antmicro/myra-sip-interposer/assets/previews/layer0.png

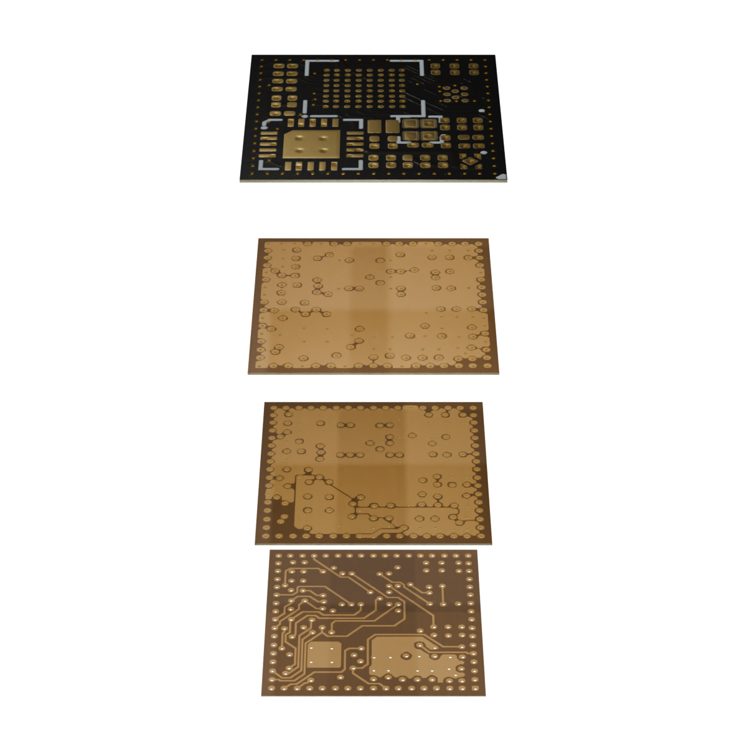
assets/previews/layer0.png
