antmicro/myra-sip-interposer/assets/previews/layer2_thumbnail.png

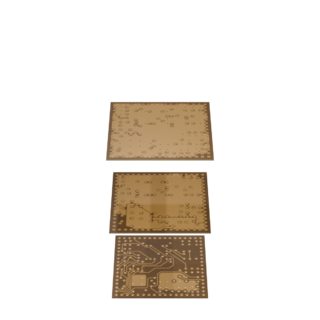
assets/previews/layer2_thumbnail.png
