antmicro/myra-sip-interposer/assets/previews/layer3.png

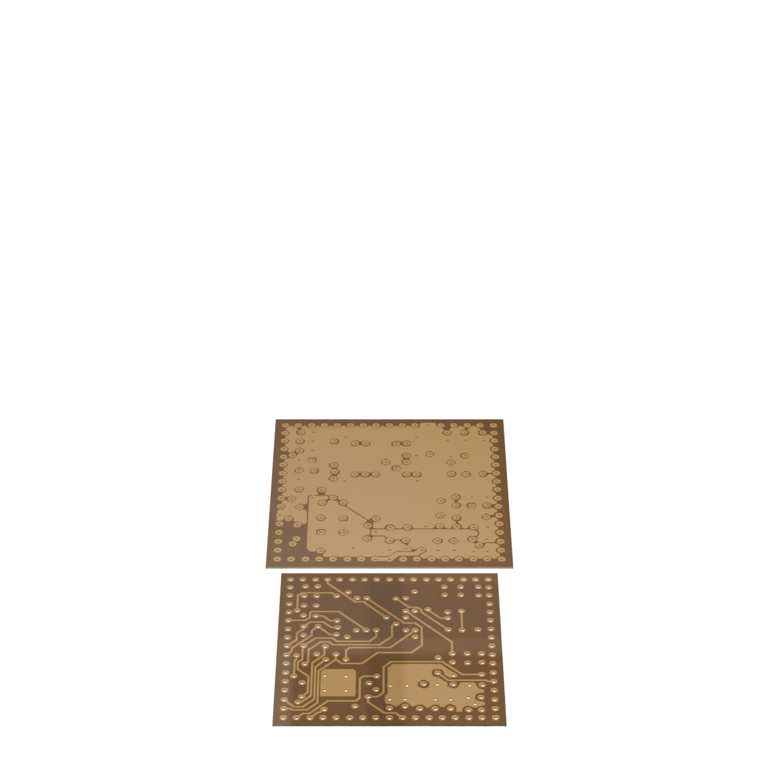
assets/previews/layer3.png
