antmicro/myra-sip-interposer/assets/previews/leftB.png

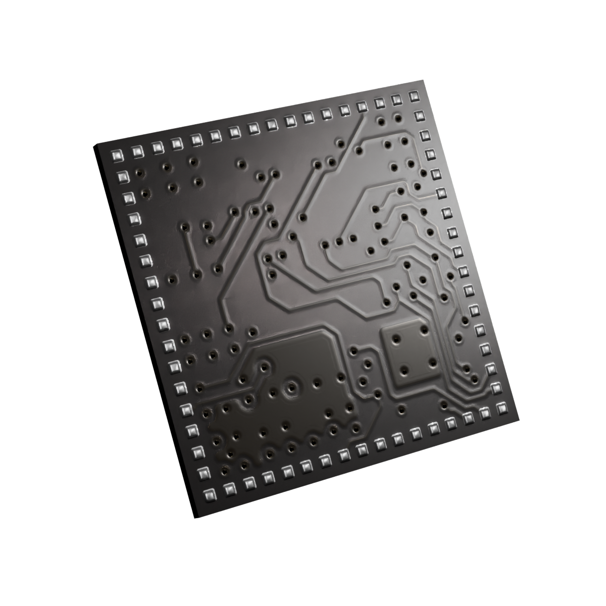
assets/previews/leftB.png
