antmicro/myra-sip-interposer/assets/previews/leftT.png

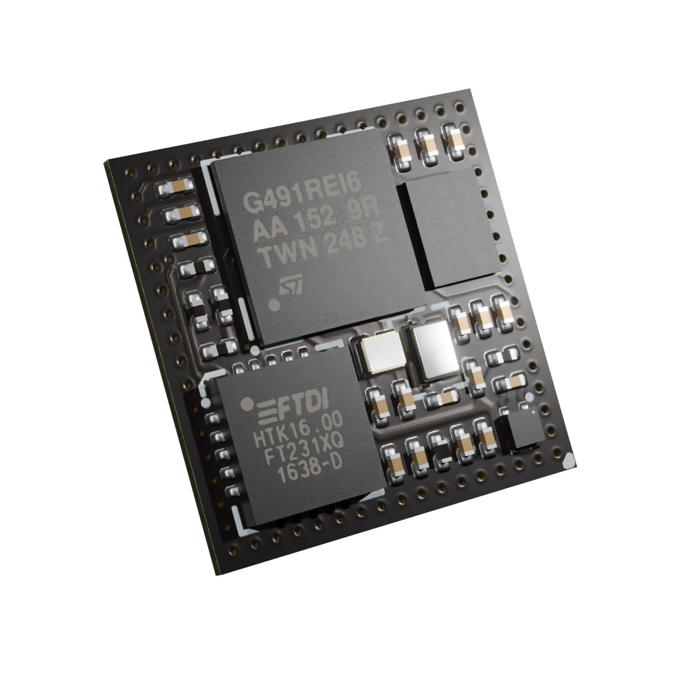
assets/previews/leftT.png
