antmicro/myra-sip-interposer/assets/previews/orthoB.png

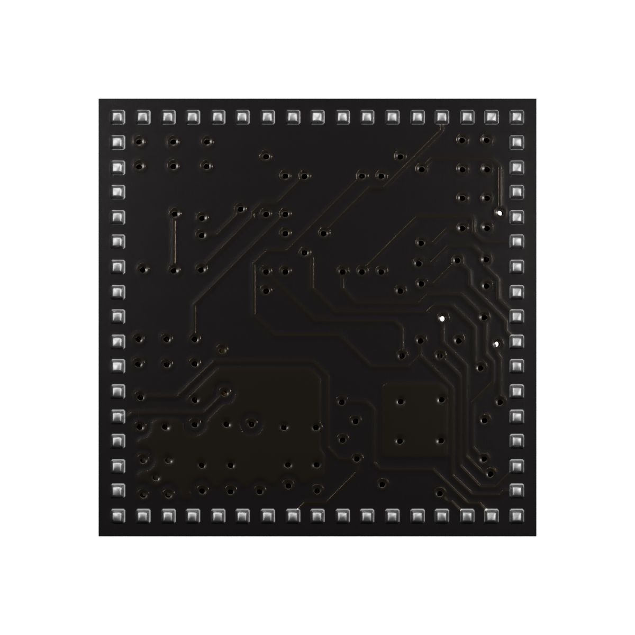
assets/previews/orthoB.png
