antmicro/myra-sip-interposer/assets/previews/rightB.png

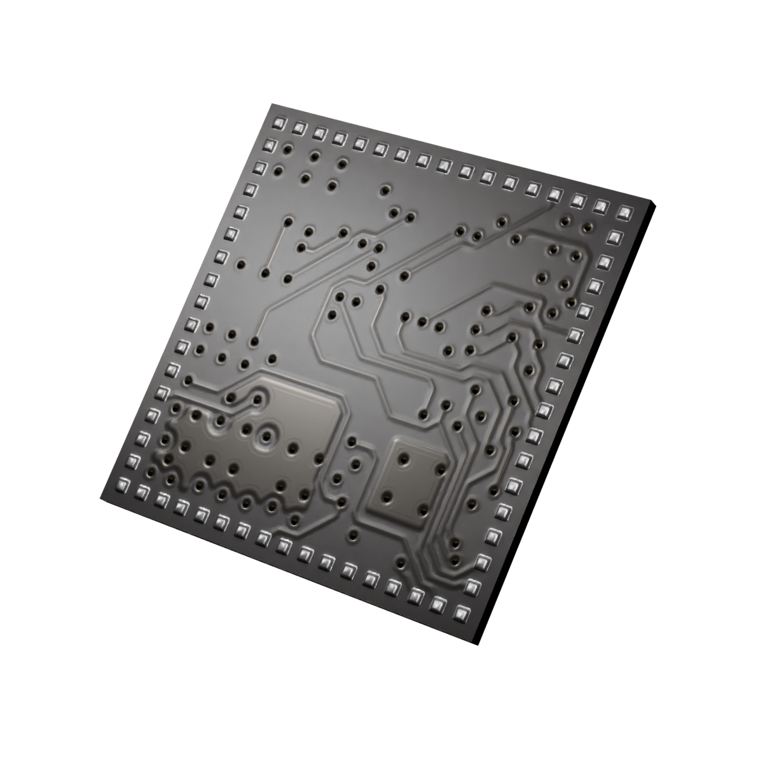
assets/previews/rightB.png
