antmicro/myra-sip-interposer/assets/previews/rightT.png

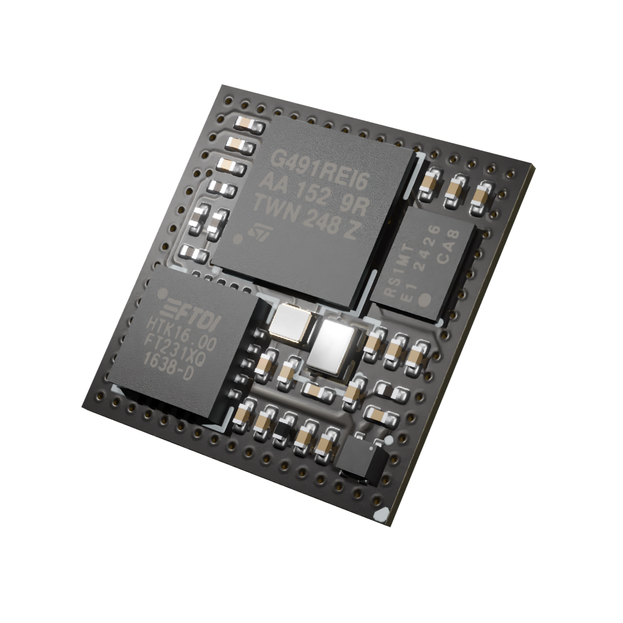
assets/previews/rightT.png
