antmicro/myra-sip-interposer/doc/myra-sip-interposer-schematic.pdf

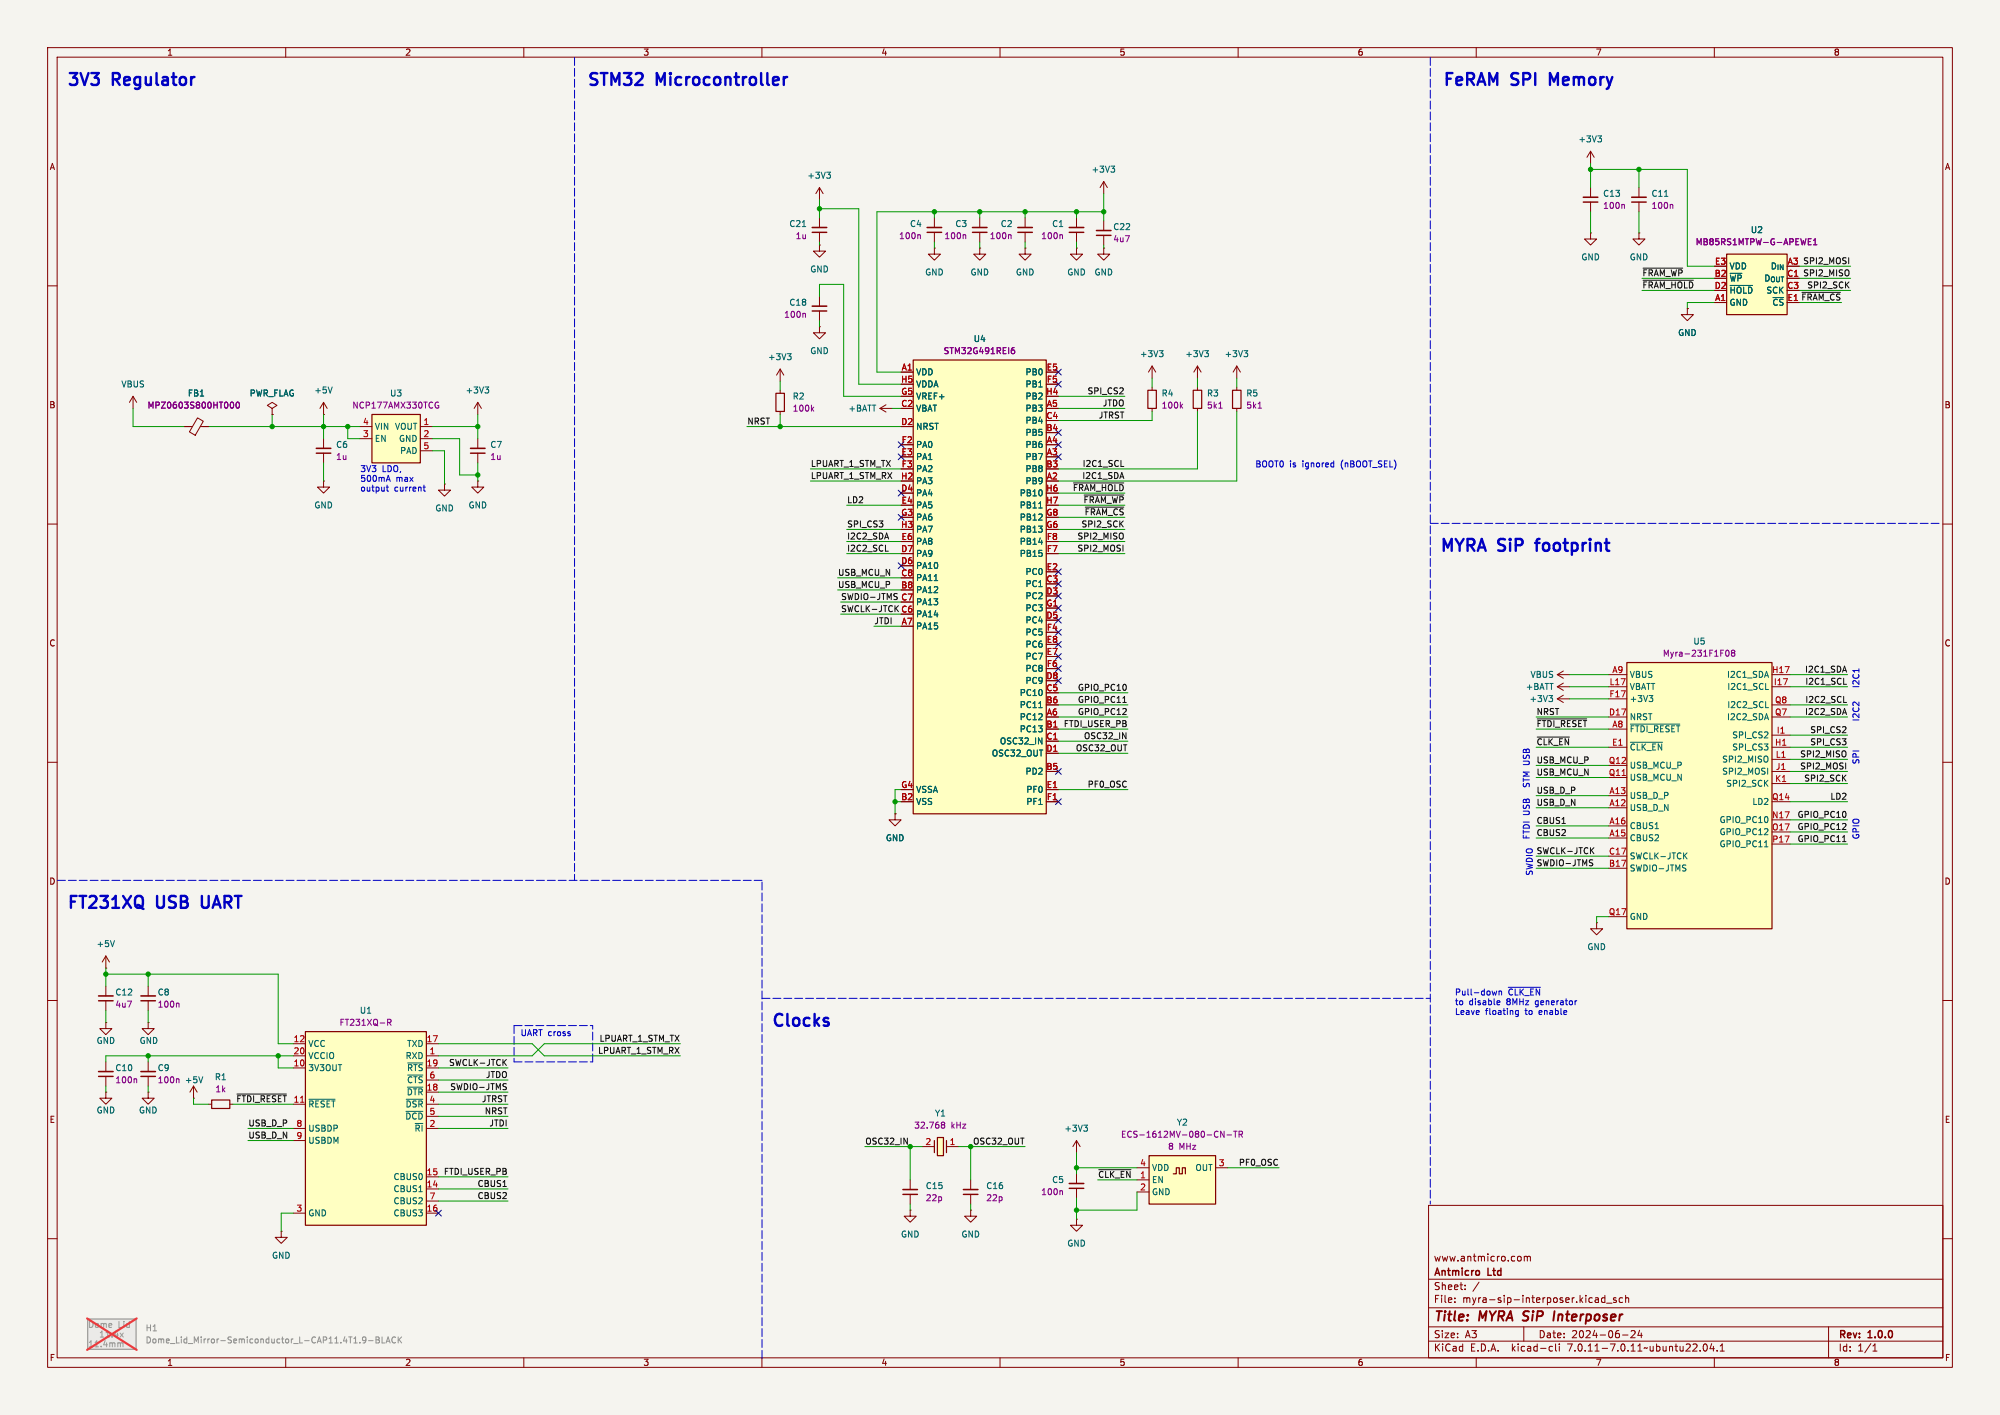
[picture p10: page 1]
