antmicro/myra-sip-interposer/(commit log)

2024-08-09 Initial commit. Add design files and assets.
    [myra-sip.kicad_pcb, myra-sip.kicad_sch, stackup.csv]
2024-08-09 [#63439] Rotate KiCad PCB design
    [myra-sip.kicad_pcb]
2024-08-09 [#63584] Rename project to Myra SiP Interposer
    [myra-sip-interposer.kicad_pcb, myra-sip-interposer.kicad_sch, stackup.csv]
2024-11-04 [#68201] Set MYRA-231F1F08 footprint as DNP
    [myra-sip-interposer.kicad_sch]
